Chittesh195/Digital-Locking-System-with-Unauthorized-Access-Alert/(list of files, drawings)

Other design files:
PCB/Sheet2.SchDoc
PCB/UPDATE.PrjPcb
PROTEUS_SIMULATION/23ECE381C10_Open Lab 1_Simulation.pdsprj
