Chittesh195/Digital-Locking-System-with-Unauthorized-Access-Alert/DOCUMENTS/23ECE381C10_Open Lab 1_Results.pdf

23ECE381

Open Laboratory I

Group ID: 23ECE381C10

For Correct Password:

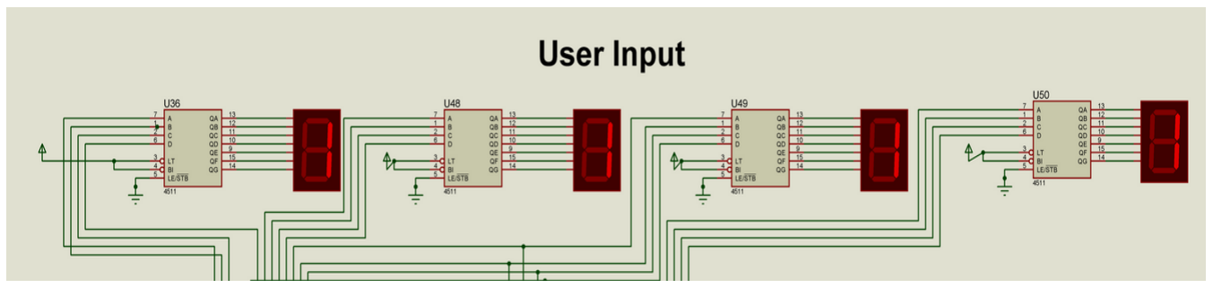
[picture p16: figure]

Fig. 1 User enters code 1111 for the digital lock

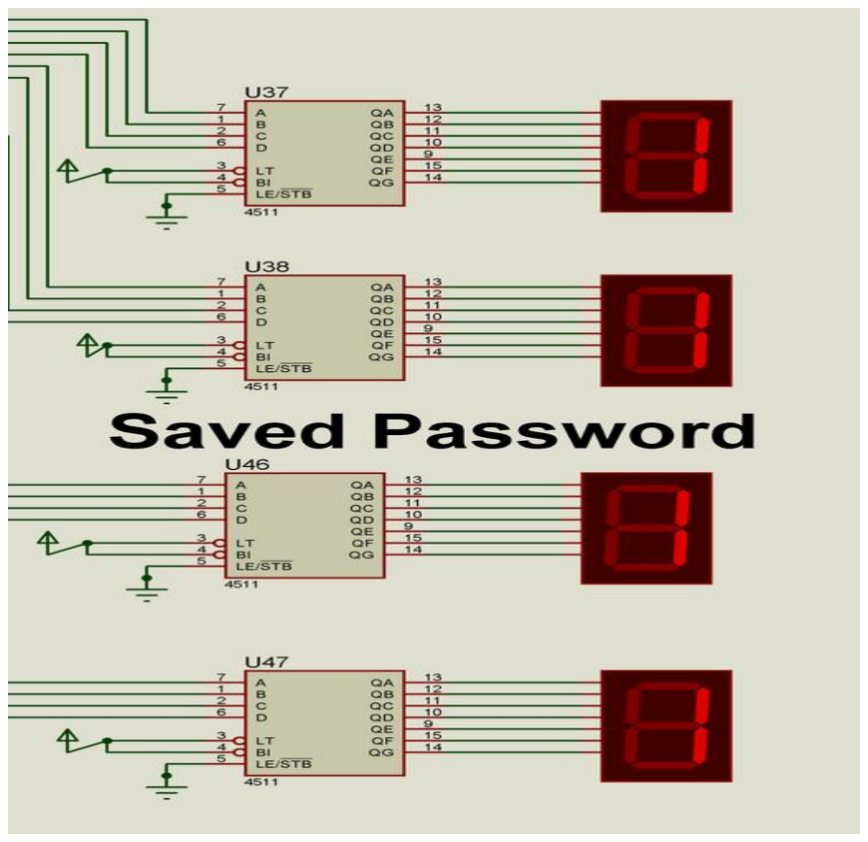
[picture p17: figure]

Fig. 2 Saved Password is 1111 for the digital lock

CB.EN.U4ECE23212 | CHITTESH S
CB.EN.U4ECE23246 | SRICHARAN R P
CB.EN.U4ECE23249 | SUJITH KRISHNA P G

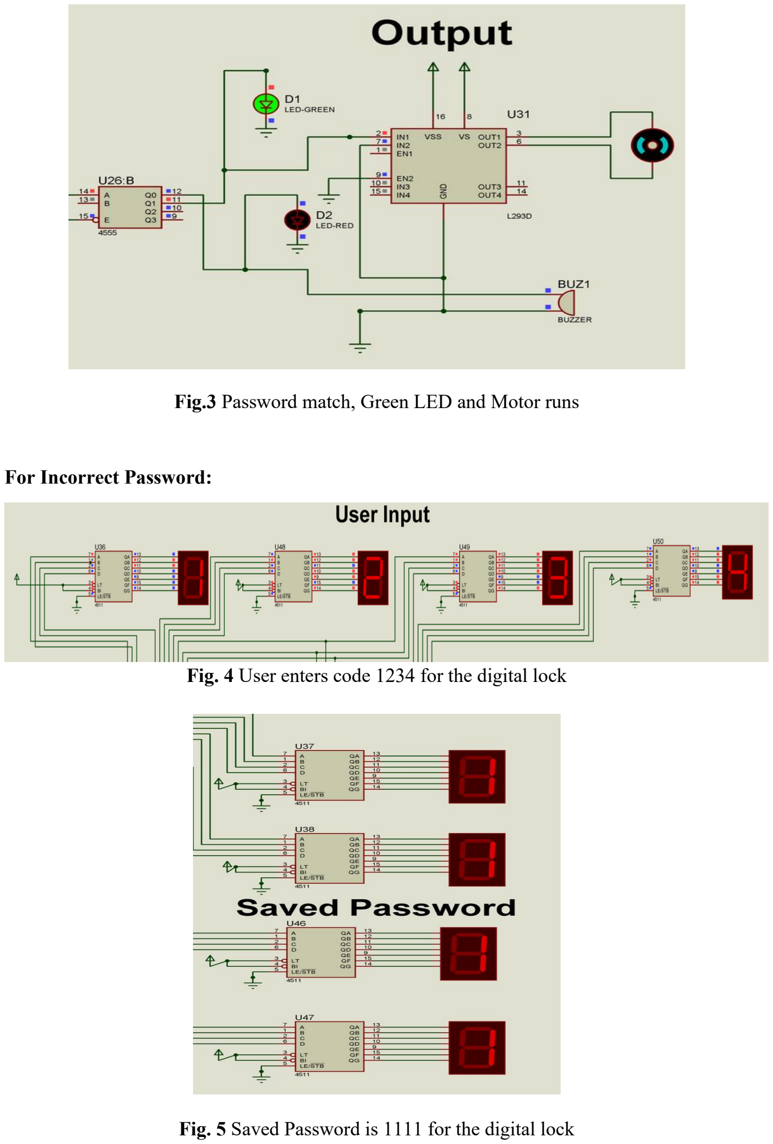
[picture p18: page 2]

Fig.3 Password match, Green LED and Motor runs

For Incorrect Password:

Fig. 4 User enters code 1234 for the digital lock

Fig. 5 Saved Password is 1111 for the digital lock

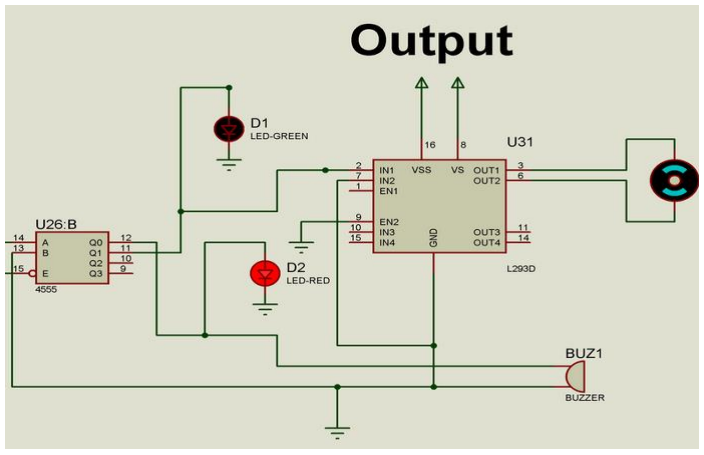
[picture p19: figure]

Fig.6 Password mismatch, Red LED and Buzzer runs
