Chittesh195/Digital-Locking-System-with-Unauthorized-Access-Alert/(commit log)

2026-03-11 Create PCB
2026-03-11 Rename 23ECE381C10_Open Lab 1_Simulation.pdsprj to PROTEUS_SIMULATION/23ECE381C10_Open Lab 1_Simulation.pdsprj
    [23ECE381C10_Open Lab 1_Simulation.pdsprj]
